ECE477-trumpet-melody/hardware/TrumpetMelody/LI0805G201R-10.step

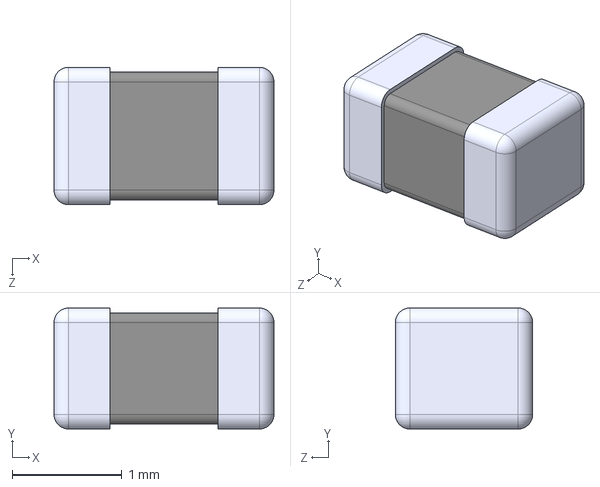
[picture p1: CAD file, 2024-02-23]
TrumpetMelody/LI0805G201R-10.step
2.00 x 1.10 x 1.25 mm
