ECE477-trumpet-melody/hardware/TrumpetMelody/MAX98357AETE_T.step

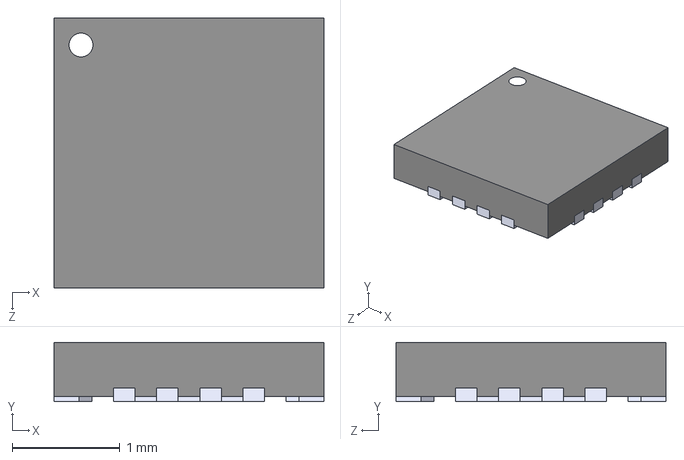
[picture p2: CAD file, 2024-02-23]
TrumpetMelody/MAX98357AETE_T.step
2.50 x 0.55 x 2.50 mm
