ECE477-trumpet-melody/hardware/TrumpetMelody/640456-3.step

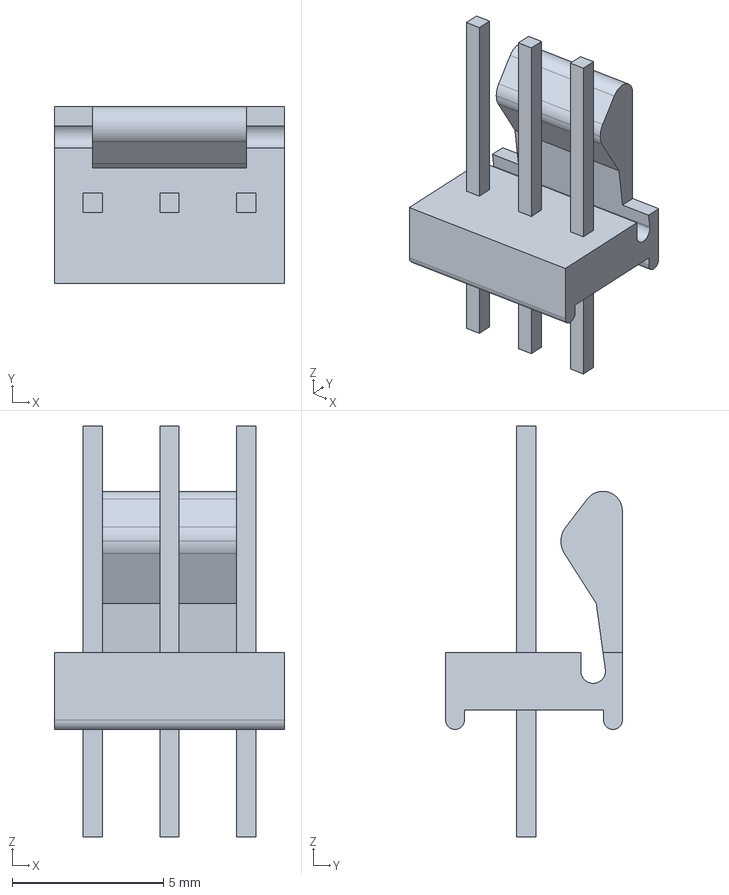
[picture p3: CAD file, 2024-02-23]
TrumpetMelody/640456-3.step
7.62 x 5.84 x 13.6 mm
