ECE477-trumpet-melody/hardware/TrumpetMelody/TrumpetMelody.kicad_pcb

## KiCad design TrumpetMelody/TrumpetMelody.kicad_pcb (2024-03-08)

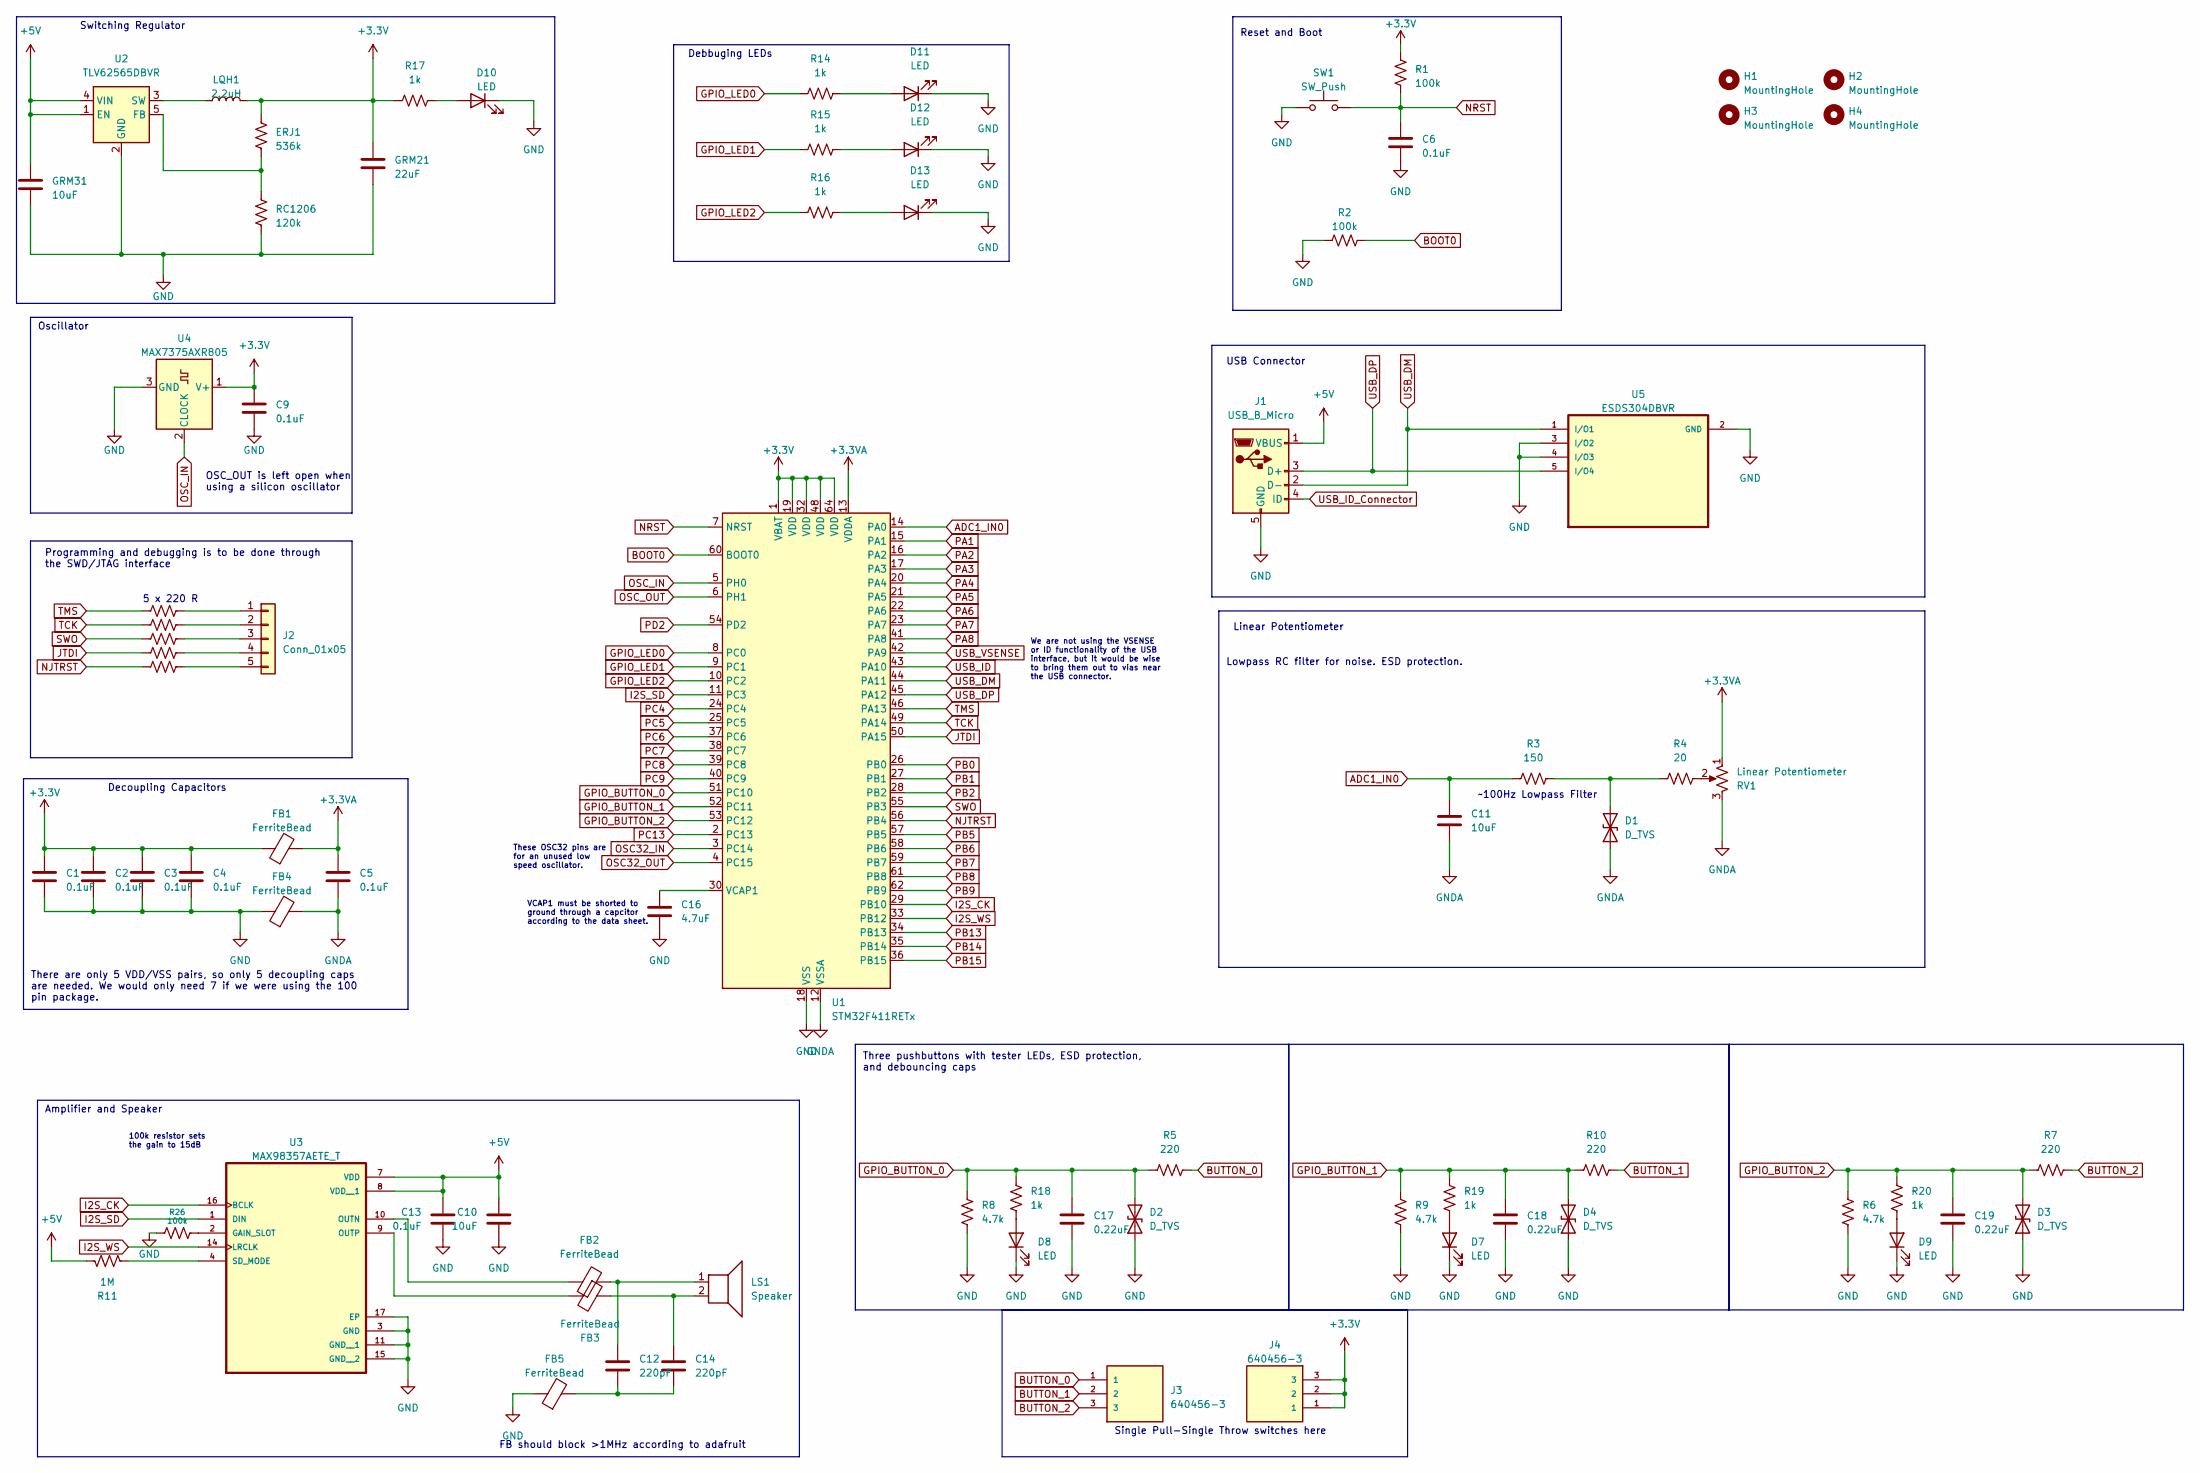
[picture p4: schematic TrumpetMelody.kicad_sch]

Parts:
C1, C2, C3, C4, C5, C6, C9, C13: 0.1uF; C_0805_2012Metric_Pad1.18x1.45mm_HandSolder
C10, C11: 10uF; C_0805_2012Metric_Pad1.18x1.45mm_HandSolder
C12, C14: 220pF; C_0805_2012Metric_Pad1.18x1.45mm_HandSolder
C16: 4.7uF; C_0805_2012Metric_Pad1.18x1.45mm_HandSolder
C17, C18, C19: 0.22uF; C_0805_2012Metric_Pad1.18x1.45mm_HandSolder
D1, D2, D3, D4: D_TVS; D_0805_2012Metric
D7, D8, D9, D10, D11, D12, D13: LED; LED_0805_2012Metric_Pad1.15x1.40mm_HandSolder
ERJ1: 536k; R_0805_2012Metric_Pad1.20x1.40mm_HandSolder
FB1, FB2, FB3, FB4, FB5: FerriteBead; FB_LI0805G201R-10
GRM21: 22uF; C_0805_2012Metric_Pad1.18x1.45mm_HandSolder
GRM31: 10uF; C_1206_3216Metric_Pad1.33x1.80mm_HandSolder
H1, H2, H3, H4: MountingHole; MountingHole_3.5mm
J1: USB_B_Micro; TE_2172034-1
J2: Conn_01x05; PinHeader_1x05_P2.54mm_Vertical
J3, J4: 640456-3; TE_640456-3; PARTREV R
LQH1: 2.2uH; L_Murata_LQH55DN_5.7x5.0mm
LS1: Speaker; TE_640456-3
R1, R2, R26: 100k; R_0805_2012Metric_Pad1.20x1.40mm_HandSolder
R3: 150; R_0805_2012Metric_Pad1.20x1.40mm_HandSolder
R4: 20; R_0805_2012Metric_Pad1.20x1.40mm_HandSolder
R5, R7, R10, R21, R22, R23, R24, R25: 220; R_0805_2012Metric_Pad1.20x1.40mm_HandSolder
R6, R8, R9: 4.7k; R_0805_2012Metric_Pad1.20x1.40mm_HandSolder
R11: 1M; R_0805_2012Metric_Pad1.20x1.40mm_HandSolder
R14, R15, R16, R17, R18, R19, R20: 1k; R_0805_2012Metric_Pad1.20x1.40mm_HandSolder
RC1206: 120k; R_1206_3216Metric_Pad1.30x1.75mm_HandSolder
RV1: Linear Potentiometer; TE_640456-3
SW1: SW_Push; SW_SPST_PTS645
U1: STM32F411RETx; LQFP-64_10x10mm_P0.5mm
U2: TLV62565DBVR; SOT-23-5_HandSoldering
U3: MAX98357AETE_T; 21-0136I_T1633-4_MXM-M
U4: MAX7375AXR805; SOT-323_SC-70
U5: ESDS304DBVR; SOT95P280X145-5N

Connections:
+3.3V: C1.1, C2.1, C3.1, C4.1, C9.1, ERJ1.1, FB1.1, GRM21.1, J4.1, J4.2, J4.3, LQH1.2, R1.1, R17.1, U1.1 (VBAT), U1.19 (VDD), U1.32 (VDD), U1.48 (VDD), U1.64 (VDD), U4.1 (V+)
+3.3VA: C5.1, FB1.2, RV1.1, U1.13 (VDDA)
+5V: C10.1, C13.1, GRM31.1, J1.1 (VBUS), R11.1, U2.1 (EN), U2.4 (VIN), U3.7 (VDD), U3.8 (VDD__1)
ADC1_IN0: C11.1, R3.1, U1.14 (PA0)
BOOT0: R2.2, U1.60 (BOOT0)
BUTTON_0: J3.1, R5.2
BUTTON_1: J3.2, R10.2
BUTTON_2: J3.3, R7.2
GND: C1.2, C2.2, C3.2, C4.2, C6.2, C9.2, C10.2, C13.2, C16.2, C17.2, C18.2, C19.2, D2.1 (A1), D3.1 (A1), D4.1 (A1), D7.1 (K), D8.1 (K), D9.1 (K), D10.1 (K), D11.1 (K), D12.1 (K), D13.1 (K), FB4.1, FB5.1, GRM21.2, GRM31.2, J1.5 (GND), R2.1, R6.1, R8.1, R9.1, R26.1, RC1206.2, SW1.1, U1.18 (VSS), U1.31 (VSS), U1.47 (VSS), U1.63 (VSS), U2.2 (GND), U3.3 (GND), U3.11 (GND__1), U3.15 (GND__2), U3.17 (EP), U4.3 (GND), U5.2 (GND), U5.3 (I/O2), U5.4 (I/O3); also elsewhere on the board
GNDA: C5.2, C11.2, D1.1 (A1), FB4.2, RV1.3, U1.12 (VSSA)
GPIO_BUTTON_0: C17.1, D2.2 (A2), R5.1, R8.2, R18.2, U1.51 (PC10)
GPIO_BUTTON_1: C18.1, D4.2 (A2), R9.2, R10.1, R19.2, U1.52 (PC11)
GPIO_BUTTON_2: C19.1, D3.2 (A2), R6.2, R7.1, R20.2, U1.53 (PC12)
GPIO_LED0: R14.1, U1.8 (PC0)
GPIO_LED1: R15.1, U1.9 (PC1)
GPIO_LED2: R16.1, U1.10 (PC2)
I2S_CK: U1.29 (PB10), U3.16 (BCLK)
I2S_SD: U1.11 (PC3), U3.1 (DIN)
I2S_WS: U1.33 (PB12), U3.14 (LRCLK)
JTDI: R24.1, U1.50 (PA15)
NJTRST: R25.1, U1.56 (PB4)
NRST: C6.1, R1.2, SW1.2, U1.7 (NRST)
unnamed: C12.1, FB2.2, LS1.1
unnamed: C12.2, C14.2, FB5.2
unnamed: C14.1, FB3.1, LS1.2
unnamed: D1.2 (A2), R3.2, R4.1
unnamed: D7.2 (A), R19.1
unnamed: D8.2 (A), R18.1
unnamed: D9.2 (A), R20.1
unnamed: D10.2 (A), R17.2
unnamed: D11.2 (A), R14.2
unnamed: D12.2 (A), R15.2
unnamed: D13.2 (A), R16.2
unnamed: J2.1, R21.2
unnamed: J2.2, R22.2
unnamed: J2.3, R23.2
unnamed: J2.4, R24.2
unnamed: J2.5, R25.2
unnamed: R4.2, RV1.2
unnamed: C16.1, U1.30 (VCAP1)
unnamed: ERJ1.2, RC1206.1, U2.5 (FB)
unnamed: LQH1.1, U2.3 (SW)
unnamed: R26.2, U3.2 (GAIN_SLOT)
unnamed: FB2.1, U3.10 (OUTN)
unnamed: FB3.2, U3.9 (OUTP)
unnamed: R11.2, U3.4 (SD_MODE)
OSC32_IN: U1.3 (PC14)
OSC32_OUT: U1.4 (PC15)
OSC_IN: U1.5 (PH0), U4.2 (CLOCK)
OSC_OUT: U1.6 (PH1)
PA1: U1.15 (PA1)
PA2: U1.16 (PA2)
PA3: U1.17 (PA3)
PA4: U1.20 (PA4)
PA5: U1.21 (PA5)
PA6: U1.22 (PA6)
PA7: U1.23 (PA7)
PA8: U1.41 (PA8)
PB0: U1.26 (PB0)
PB1: U1.27 (PB1)
PB2: U1.28 (PB2)
PB5: U1.57 (PB5)
PB6: U1.58 (PB6)
PB7: U1.59 (PB7)
PB8: U1.61 (PB8)
PB9: U1.62 (PB9)
PB13: U1.34 (PB13)
PB14: U1.35 (PB14)
PB15: U1.36 (PB15)
PC4: U1.24 (PC4)
PC5: U1.25 (PC5)
PC6: U1.37 (PC6)
PC7: U1.38 (PC7)
PC8: U1.39 (PC8)
PC9: U1.40 (PC9)
PC13: U1.2 (PC13)
PD2: U1.54 (PD2)
SWO: R23.1, U1.55 (PB3)
TCK: R22.1, U1.49 (PA14)
TMS: R21.1, U1.46 (PA13)
USB_DM: J1.2 (D-), U1.44 (PA11), U5.1 (I/O1)
USB_DP: J1.3 (D+), U1.45 (PA12), U5.5 (I/O4)
USB_ID: U1.43 (PA10)
USB_ID_Connector: J1.4 (ID)
USB_VSENSE: U1.42 (PA9)

Notes on the sheet:
USB Connector
Switching Regulator
~100Hz Lowpass Filter
5 x 220 R
Oscillator
FB should block >1MHz according to adafruit
Single Pull-Single Throw switches here
100k resistor sets the gain to 15dB
Amplifier and Speaker
There are only 5 VDD/VSS pairs, so only 5 decoupling caps are needed. We would only need 7 if we were using the 100 pin package.
These OSC32 pins are for an unused low speed oscillator.
OSC_OUT is left open when using a silicon oscillator
Linear Potentiometer
We are not using the VSENSE or ID functionality of the USB interface, but it would be wise to bring them out to vias near the USB connector.
Programming and debugging is to be done through the SWD/JTAG interface
Three pushbuttons with tester LEDs, ESD protection, and debouncing caps
Reset and Boot
Debbuging LEDs
VCAP1 must be shorted to ground through a capcitor according to the data sheet.
Lowpass RC filter for noise. ESD protection.
Decoupling Capacitors

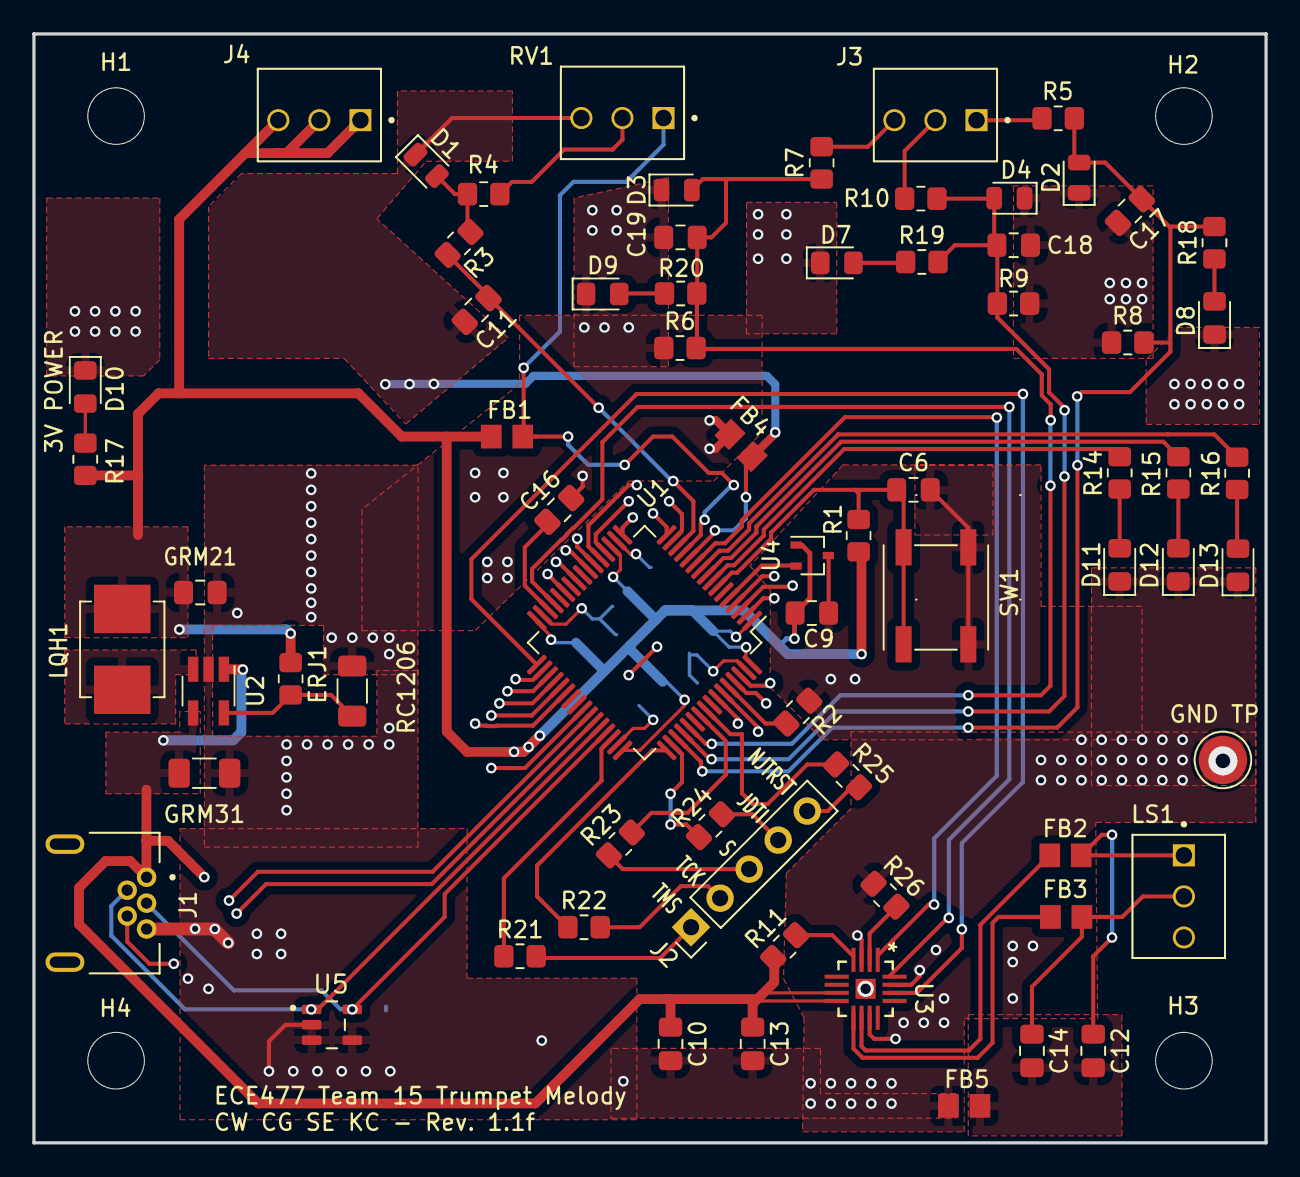
[picture p5: board TrumpetMelody.kicad_pcb from above]

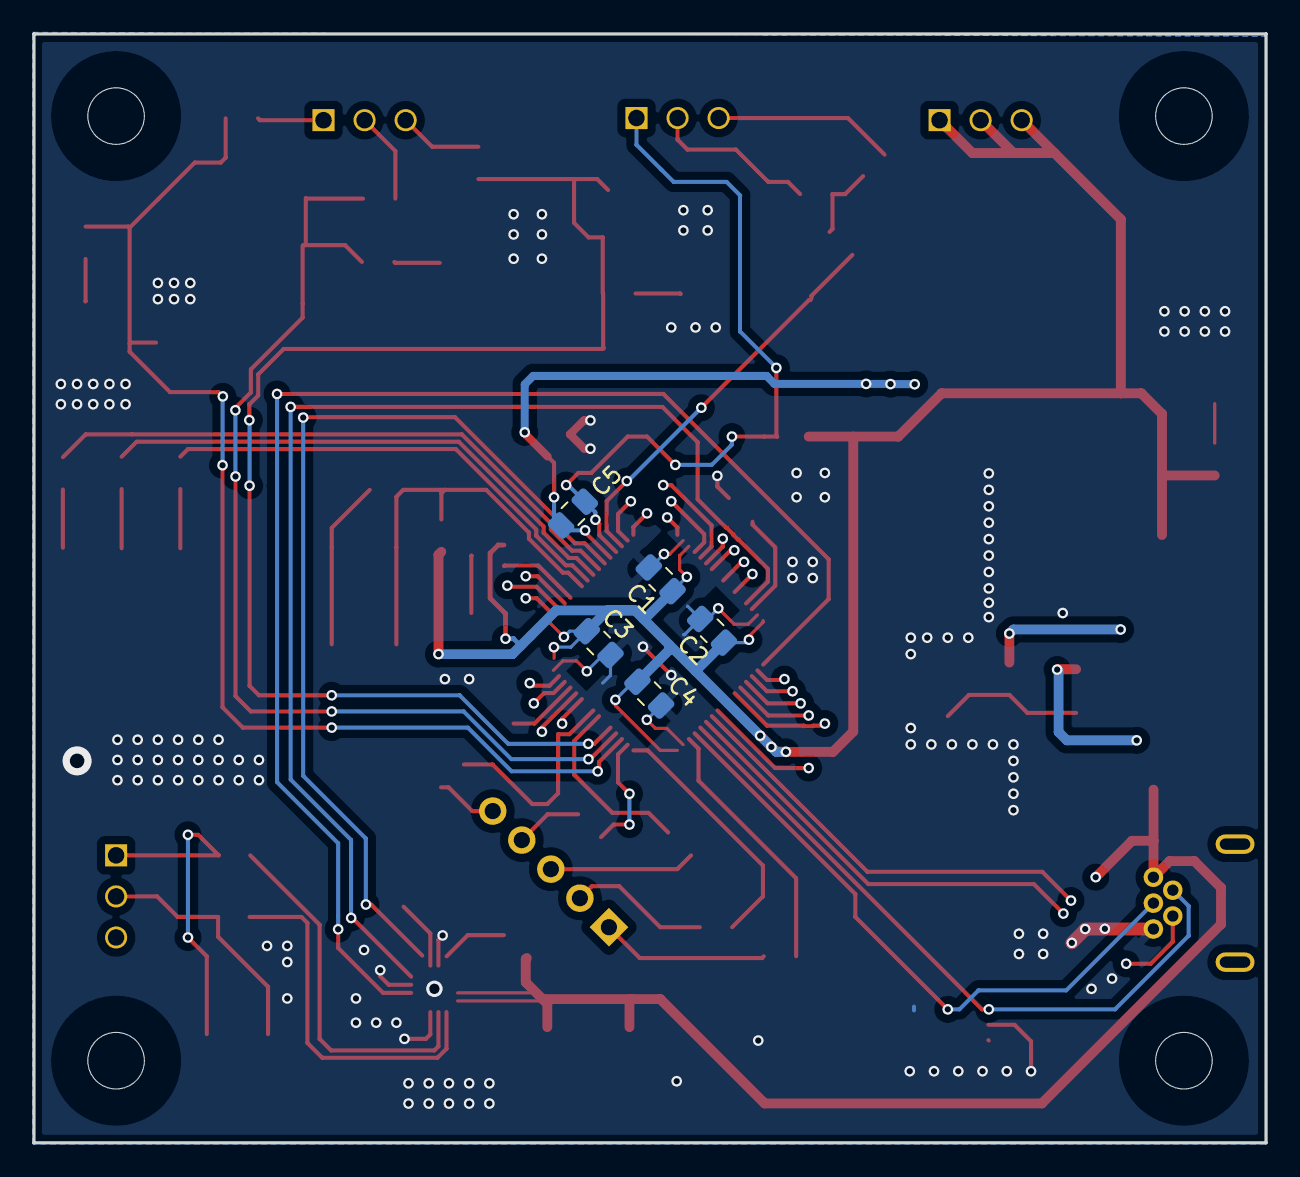
[picture p6: board TrumpetMelody.kicad_pcb from below]

Board: 2 copper layers, 76.2 x 68.6 mm, 78 parts (5 on the bottom side), 52 nets.

Other parts of the board:
GND TP: TestPoint_Pad_D3.0mm

Their connections:
GND: GND TP.1; also elsewhere on the board
