ECE477-trumpet-melody/hardware/(commit log)

2024-02-20 Started Design and imported some schematics
    Manually created and scoped out the switching regulator
    Set areas for different parts
    Started work on speakers by importing MAX98357 symbol and creating a project library
    [TrumpetMelody.kicad_sch]
2024-02-20 To CLAYTON: Marked some details out for the different components
    Please try to do the things that would be easier for you to do and harder for me to do.
    I.E. USB schem, XTAL schem, marking pins with labels, putting those labels in their corresponding boxes too, programming header.
    I can handle doing the peripherals after getting past pin assignments, I will also try to add some debugging things now, but mostly that will be done during layout.
    [TrumpetMelody.kicad_sch]
2024-02-21 Major updates, lots of first draft of components
    Put in XTAL, did a bunch of research on how to select the capacitors but it comes down to actually picking an oscillator to use, we forgot to order one.
    Accidentally ran into the USB micro connector schematic and that was super easy, but we might need to modify for ESD and shielding.
    Tried to do the programming pins, but I had trouble finding something on how those work and how we will do it, Clayton can probably handle that another time.
    Added linear potentiometer leading into 100Hz lowpass filter, and ESD
    Added buttons with ESD
    [TrumpetMelody.kicad_sch]
2024-02-21 Added speakers and amplifier
    Yeah i think this is fine for now
    [TrumpetMelody.kicad_sch]
2024-02-21 made manlab changes
    [TrumpetMelody.kicad_sch]
2024-02-21 Added debugging LEDs
    [TrumpetMelody.kicad_sch]
2024-02-21 edits to button tester LEDs & positioning
2024-02-21 edited more LEDs
    [TrumpetMelody.kicad_sch]
2024-02-22 Added labels to every pin
    [TrumpetMelody.kicad_sch]
2024-02-23 Added gain resistor to speaker circuit
    [TrumpetMelody.kicad_sch]
2024-02-23 Added debouncing caps to the buttons
    [TrumpetMelody.kicad_sch]
2024-02-23 finished schematic and intialized PCB
    [640456-3.step, LI0805G201R-10.step, MAX98357AETE_T.step, TrumpetMelody.kicad_pcb, TrumpetMelody.kicad_sch]
2024-02-23 set board parameters (poorly) and put some stuff in rought spacing
    [TrumpetMelody.kicad_pcb]
2024-02-24 Fixed grounds on the speaker and potentiometer
    [TrumpetMelody.kicad_sch]
2024-02-24 switching regulator/USB in place, some silkscreen stuff, defined edges
    [TrumpetMelody.kicad_pcb]
2024-02-24 modifying some regulator placement
    [TrumpetMelody.kicad_pcb]
2024-02-24 more changes to 5V side
    [TrumpetMelody.kicad_pcb]
2024-02-25 Added decoupling caps to the micro
    [TrumpetMelody.kicad_pcb, TrumpetMelody.kicad_sch]
2024-02-25 condensed 5V side
2024-02-26 more 3V stuff added in, nearly done micro connections
    [TrumpetMelody.kicad_pcb]
2024-02-26 everything onboard except for the buttons- see notes on pcb drawing.
    [TrumpetMelody.kicad_pcb]
2024-02-26 changes to notes
    [TrumpetMelody.kicad_pcb]
2024-02-26 Added power bus to micro side
    [TrumpetMelody.kicad_pcb]
2024-02-26 put the FBs and the button components on the board.
    [TrumpetMelody.kicad_pcb]
2024-02-27 Changed +3.3V on the poteniometer to +3.3VA
    [TrumpetMelody.kicad_pcb, TrumpetMelody.kicad_sch]
2024-02-27 Slight change to the 3.3VA decoupling cap
    [TrumpetMelody.kicad_pcb]
2024-02-27 Fixed poteniometer power line
    [TrumpetMelody.kicad_pcb]
2024-02-27 changed 5V line a little, changed a signal crossing
    [TrumpetMelody.kicad_pcb]
2024-02-27 usb signal slight change
    [TrumpetMelody.kicad_pcb]
2024-02-27 slight changes to a resistor positioning
    [TrumpetMelody.kicad_pcb]
2024-02-27 i am going to scream why do the silkscreen references keep changing
    [TrumpetMelody.kicad_pcb]
2024-02-27 silkscreen >:(
    [TrumpetMelody.kicad_pcb]
2024-02-27 Manually added TI Webench PCB layout
    I just sort of rotated the picture and drew it on
    There's a bunch of holes in the PCB layout and I don't know if those are supposed to be vias or whatever. I may have used the wrong type of hole to switch board sides too.
    [TrumpetMelody.kicad_pcb]
2024-02-27 a diode on the linear pot got disconnected so i reconnected it
    [TrumpetMelody.kicad_pcb]
2024-02-27 Added stitching vias
    [TrumpetMelody.kicad_pcb]
2024-02-27 Placed vias so we can connect USB_ID and USB_VSENSE later if needed
    [TrumpetMelody.kicad_pcb]
2024-02-27 Initialized GND Planes and tweaked stitching vias
    [TrumpetMelody.kicad_pcb]
2024-02-28 slight wire changes and connected some of the ground bus to the usb input ground
2024-02-28 public enemy #1: analog ground
    [TrumpetMelody.kicad_pcb]
2024-02-28 Added FB to simplify AGND
    [TrumpetMelody.kicad_pcb, TrumpetMelody.kicad_sch]
2024-02-28 Updated TVS Diodes to be right size and fixed placements
    [TrumpetMelody.kicad_pcb, TrumpetMelody.kicad_sch]
2024-02-28 Added GND plane to amplifier circuitry
    [TrumpetMelody.kicad_pcb]
2024-02-28 Added a bunch of ground planes
    [TrumpetMelody.kicad_pcb, TrumpetMelody.kicad_sch]
2024-02-28 Added a ground test point
    [TrumpetMelody.kicad_pcb]
2024-02-28 Pulled out most of the GPIO pins to vias
    [TrumpetMelody.kicad_pcb, TrumpetMelody.kicad_sch]
2024-02-28 Fixed the analog ground on the micro
    [TrumpetMelody.kicad_pcb]
2024-02-28 Fixed DRC errors
    [TrumpetMelody.kicad_pcb, TrumpetMelody.kicad_sch]
2024-02-28 Printed Schematic Out
    [TrumpetMelody.kicad_pcb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]
2024-02-28 via sizes
    [TrumpetMelody.kicad_pcb]
2024-02-28 Removed question marks from schematic
    [TrumpetMelody.kicad_sch]
2024-02-29 zip file
    [TrumpetMelody-NPTH.drl, TrumpetMelody-PTH.drl]
2024-02-29 slight wiring modifications
    [TrumpetMelody.kicad_pcb]
2024-02-29 modified the USB traces bc one of the turns was too turney
    [TrumpetMelody.kicad_pcb]
2024-02-29 need to fix DRC issues soon
    [TrumpetMelody.kicad_pcb]
2024-03-06 tbd list readded with things that need to be done
    [TrumpetMelody.kicad_pcb]
2024-03-06 modified the DRC rules based on jlcpcb minimums and DRC lit up like a christmas tree so i will be slowly going through that stuff
    [TrumpetMelody.kicad_pcb]
2024-03-06 christmas tree of DRC pointers
    [TrumpetMelody.kicad_pcb]
2024-03-06 finished DRC complaints pls verify the last warning ty
    [TrumpetMelody.kicad_pcb]
2024-03-06 something autorouted and i just noticed it but now it is fixed
    [TrumpetMelody.kicad_pcb]
2024-03-06 Fixed a right angle
    [TrumpetMelody.kicad_pcb]
2024-03-06 changed some traces
    [TrumpetMelody.kicad_pcb]
2024-03-06 added alligator
    [TrumpetMelody.kicad_pcb]
2024-03-06 Finished PCB
    [TrumpetMelody.kicad_pcb]
2024-03-06 Minor edits
    [TrumpetMelody.kicad_pcb]
2024-03-07 Changed button footprint and verified design
    [TrumpetMelody.kicad_pcb]
2024-03-07 New ESD protection on USB and verified
    [TrumpetMelody.kicad_pcb, TrumpetMelody.kicad_sch]
2024-03-07 changes to DP/DM signals to reduce via usage/turns, slight change to the button 0 routing bc i saw an acute angle
    [TrumpetMelody.kicad_pcb]
2024-03-08 adjusted one trace
    [TrumpetMelody.kicad_pcb]
2024-03-08 Readded? gerbers, there should have been some already
    only did the basic plot gerber, also made sure to not tent vias
    [TrumpetMelody-B_Cu.gbr, TrumpetMelody-B_Mask.gbr, TrumpetMelody-B_Paste.gbr, TrumpetMelody-B_Silkscreen.gbr, TrumpetMelody-Edge_Cuts.gbr, TrumpetMelody-F_Cu.gbr, TrumpetMelody-F_Mask.gbr, TrumpetMelody-F_Paste.gbr]
2024-03-08 Made ground trace larger
    [TrumpetMelody.kicad_pcb]
2024-03-08 Updated PCB on website
    [TrumpetMelody-B_Cu.gbr, TrumpetMelody-B_Mask.gbr, TrumpetMelody-B_Paste.gbr, TrumpetMelody-B_Silkscreen.gbr, TrumpetMelody-Edge_Cuts.gbr, TrumpetMelody-F_Cu.gbr, TrumpetMelody-F_Mask.gbr, TrumpetMelody-F_Paste.gbr]
